Adrisbd11/Custom-Nanorobot-Control-Inverter/DATASHEETS/BMI Electronic Hardware PR-Photo.jpg

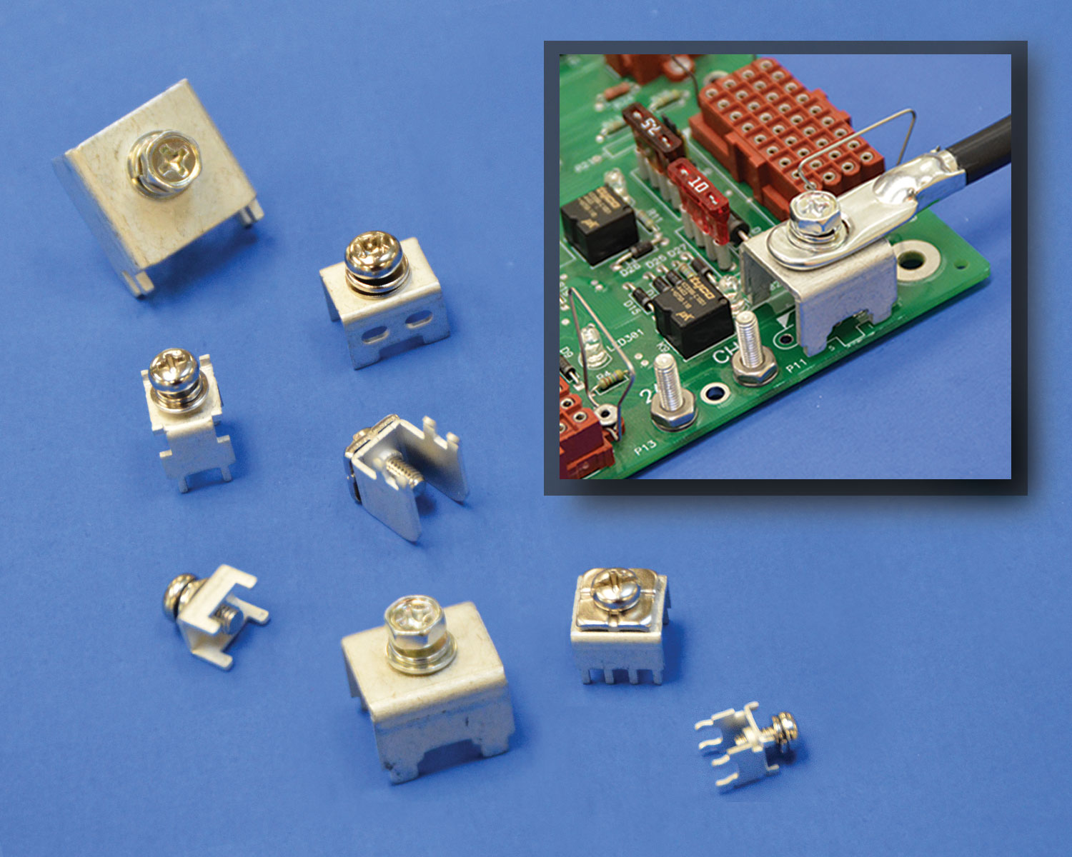
DATASHEETS/BMI Electronic Hardware PR-Photo.jpg
