Adrisbd11/Custom-Nanorobot-Control-Inverter/DATASHEETS/6130XX11821_61301811821/6130XX11821_61301811821.step

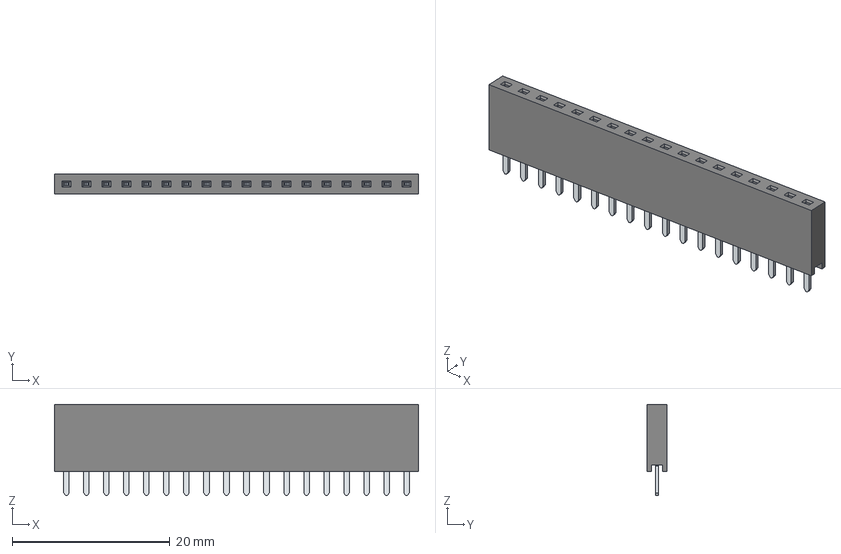
[picture p2: CAD file, 2026-04-30]
DATASHEETS/6130XX11821_61301811821/6130XX11821_61301811821.step
46.2 x 2.50 x 11.6 mm
