Adrisbd11/Custom-Nanorobot-Control-Inverter/DATASHEETS/C5750X7R2A475M230KA/C5750X7R2A475M230KA.step

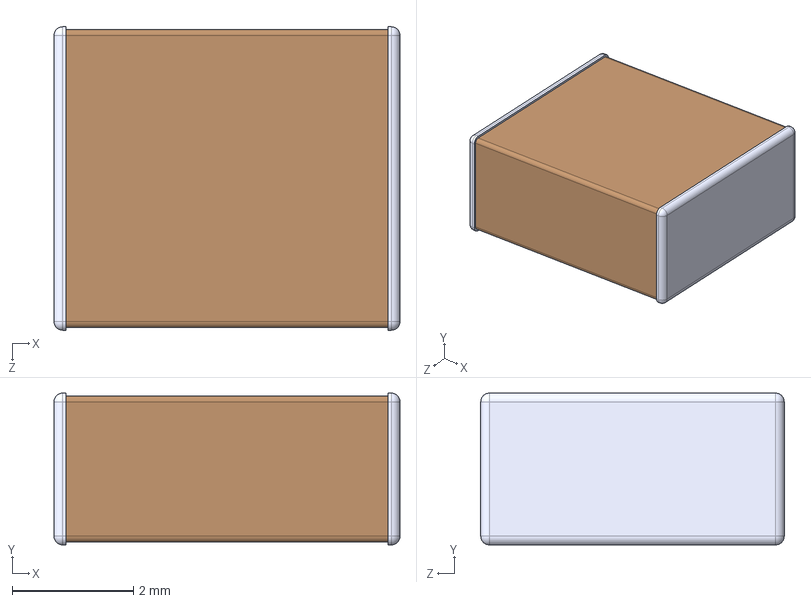
[picture p3: CAD file, 2026-04-30]
DATASHEETS/C5750X7R2A475M230KA/C5750X7R2A475M230KA.step
5.70 x 2.50 x 5.00 mm
