Adrisbd11/Custom-Nanorobot-Control-Inverter/DATASHEETS/LIB_2EDL23N06PJ/2EDL23N06PJ/3D/2EDL23N06PJ.stp

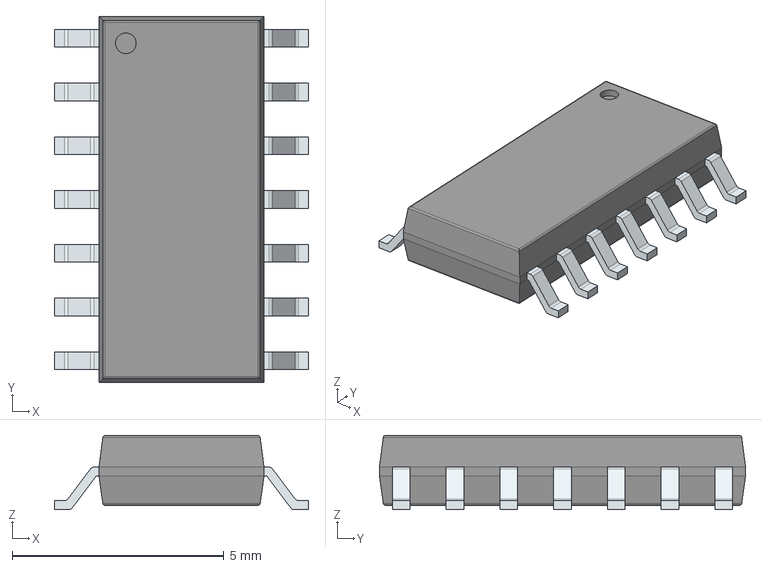
[picture p4: CAD file, 2026-04-17]
DATASHEETS/LIB_2EDL23N06PJ/2EDL23N06PJ/3D/2EDL23N06PJ.stp
6.00 x 8.65 x 1.75 mm
PinsArrayLR
