Adrisbd11/Custom-Nanorobot-Control-Inverter/DATASHEETS/LIB_C5750X6S2W225K250KA/C5750X6S2W225K250KA/3D/C5750X6S2W225K250KA.stp

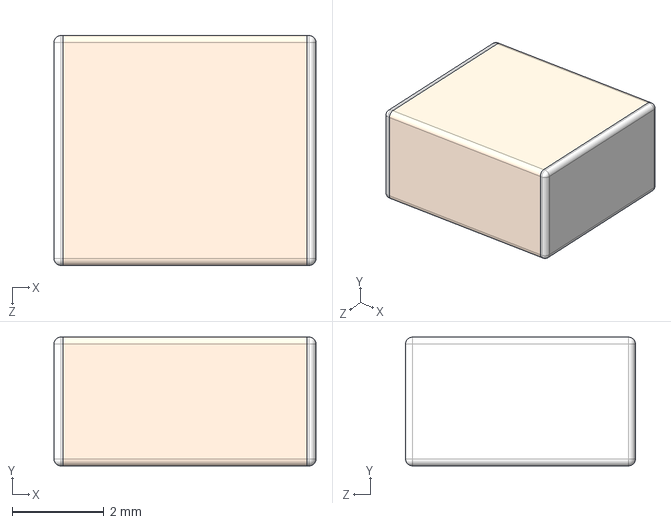
[picture p5: CAD file, 2026-04-30]
DATASHEETS/LIB_C5750X6S2W225K250KA/C5750X6S2W225K250KA/3D/C5750X6S2W225K250KA.stp
5.70 x 2.80 x 5.00 mm
