Adrisbd11/Custom-Nanorobot-Control-Inverter/DATASHEETS/LIB_CKSR_15-NP/CKSR_15-NP/3D/CKSR_15-NP.stp

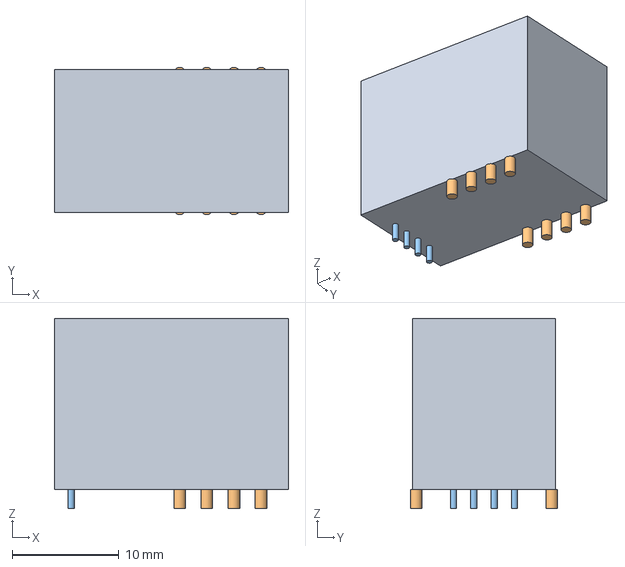
[picture p6: CAD file, 2026-04-17]
DATASHEETS/LIB_CKSR_15-NP/CKSR_15-NP/3D/CKSR_15-NP.stp
21.9 x 13.8 x 17.8 mm
Lugs x 12
