Adrisbd11/Custom-Nanorobot-Control-Inverter/DATASHEETS/LIB_CKSR_6-NP/CKSR_6-NP/3D/CKSR_6-NP.stp

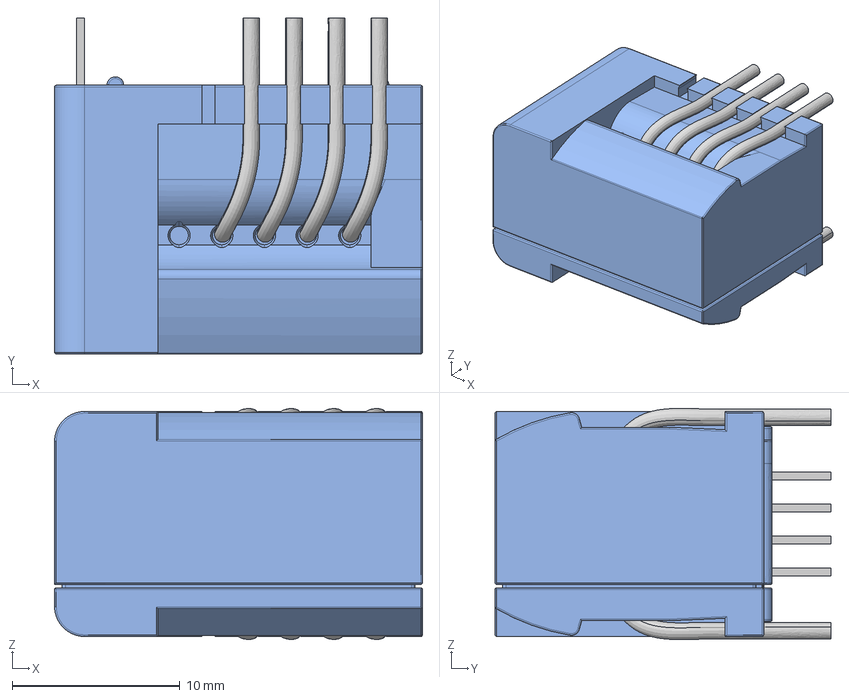
[picture p7: CAD file, 2026-04-30]
DATASHEETS/LIB_CKSR_6-NP/CKSR_6-NP/3D/CKSR_6-NP.stp
21.9 x 20.0 x 13.8 mm
1.Case
sec4.2 x 4
jumper.3 x 4
