Adrisbd11/Custom-Nanorobot-Control-Inverter/DATASHEETS/LIB_CRCW251215K0FKEG/CRCW251215K0FKEG/3D/CRCW251215K0FKEG.stp

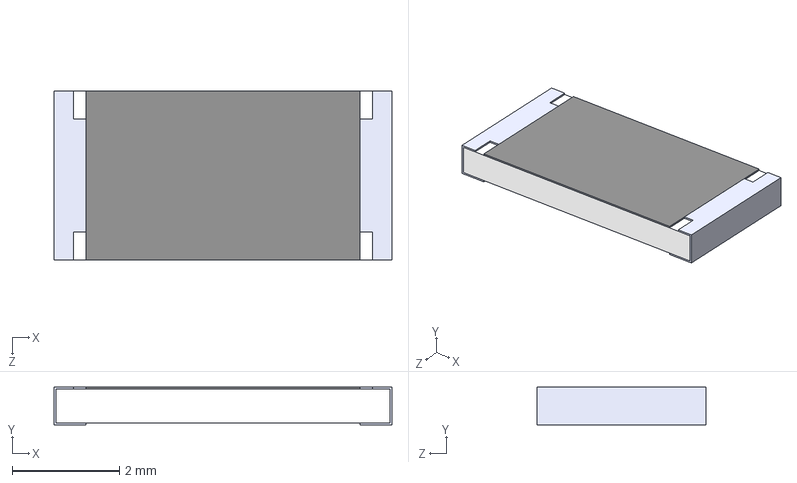
[picture p8: CAD file, 2026-04-17]
DATASHEETS/LIB_CRCW251215K0FKEG/CRCW251215K0FKEG/3D/CRCW251215K0FKEG.stp
6.30 x 0.7 x 3.15 mm
