Adrisbd11/Custom-Nanorobot-Control-Inverter/DATASHEETS/LIB_IPP111N15N3GXKSA1/IPP111N15N3GXKSA1/3D/IPP111N15N3GXKSA1.stp

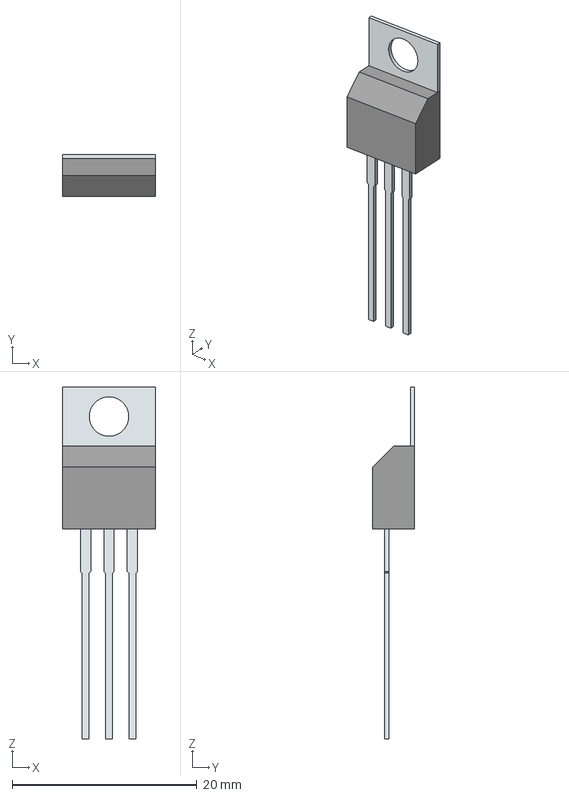
[picture p9: CAD file, 2026-04-30]
DATASHEETS/LIB_IPP111N15N3GXKSA1/IPP111N15N3GXKSA1/3D/IPP111N15N3GXKSA1.stp
10.0 x 4.57 x 38.1 mm
Tab
PinsArray
