Adrisbd11/Custom-Nanorobot-Control-Inverter/DATASHEETS/LIB_IPT034N15NM6ATMA1/IPT034N15NM6ATMA1/3D/IPT034N15NM6ATMA1.stp

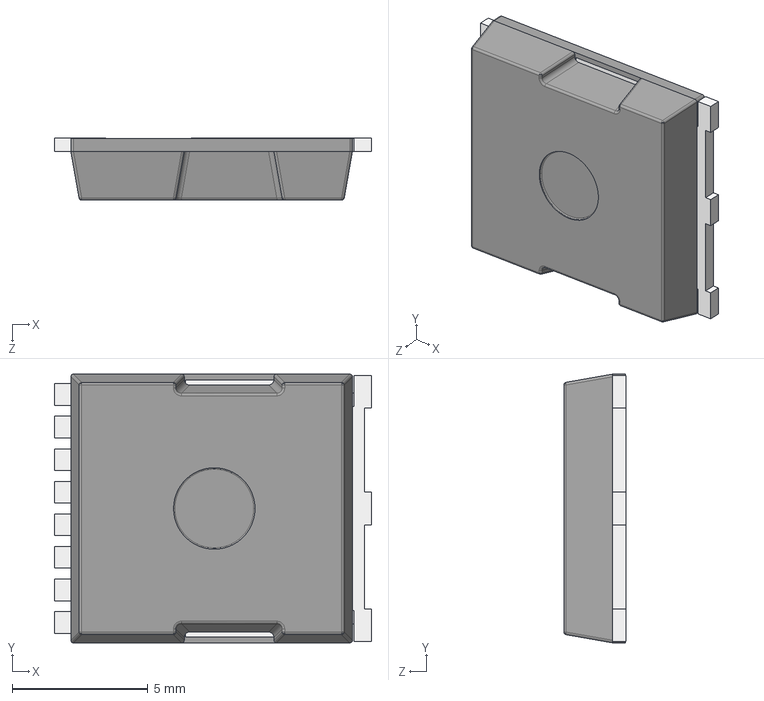
[picture p10: CAD file, 2026-04-17]
DATASHEETS/LIB_IPT034N15NM6ATMA1/IPT034N15NM6ATMA1/3D/IPT034N15NM6ATMA1.stp
11.7 x 9.90 x 2.30 mm
