Adrisbd11/Custom-Nanorobot-Control-Inverter/DATASHEETS/LIB_L6986H/L6986H/3D/L6986H.stp

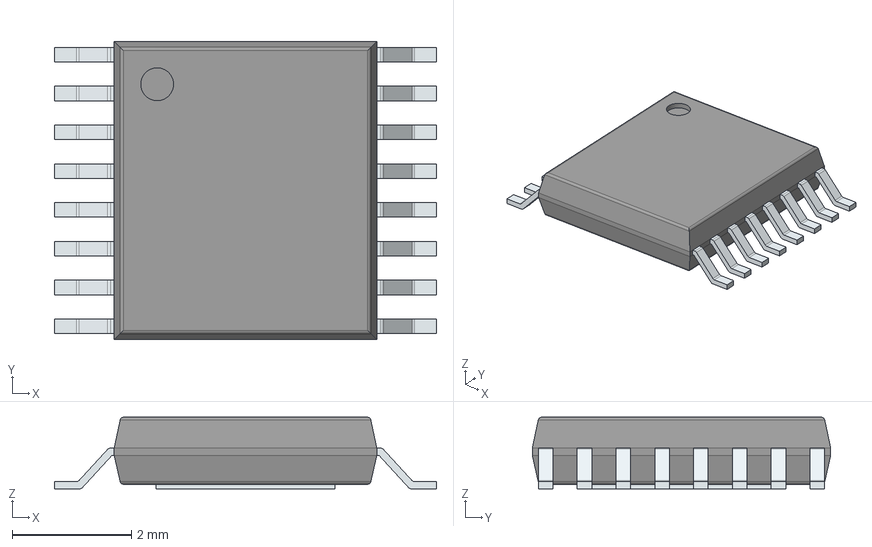
[picture p11: CAD file, 2026-04-17]
DATASHEETS/LIB_L6986H/L6986H/3D/L6986H.stp
6.40 x 5.00 x 1.20 mm
PinsArrayLR
ThermalPad
