Adrisbd11/Custom-Nanorobot-Control-Inverter/DATASHEETS/LIB_MKP1F044706J00JSSD/MKP1F044706J00JSSD/3D/MKP1F044706J00JSSD.stp

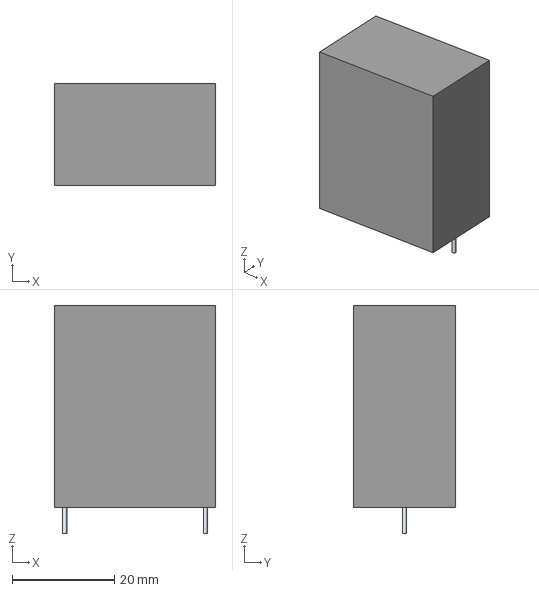
[picture p12: CAD file, 2026-04-17]
DATASHEETS/LIB_MKP1F044706J00JSSD/MKP1F044706J00JSSD/3D/MKP1F044706J00JSSD.stp
31.5 x 20.0 x 44.6 mm
Leads
