Adrisbd11/Custom-Nanorobot-Control-Inverter/DATASHEETS/LIB_MSS1P4-M3_89A/MSS1P4-M3_89A/3D/MSS1P4-M3_89A.stp

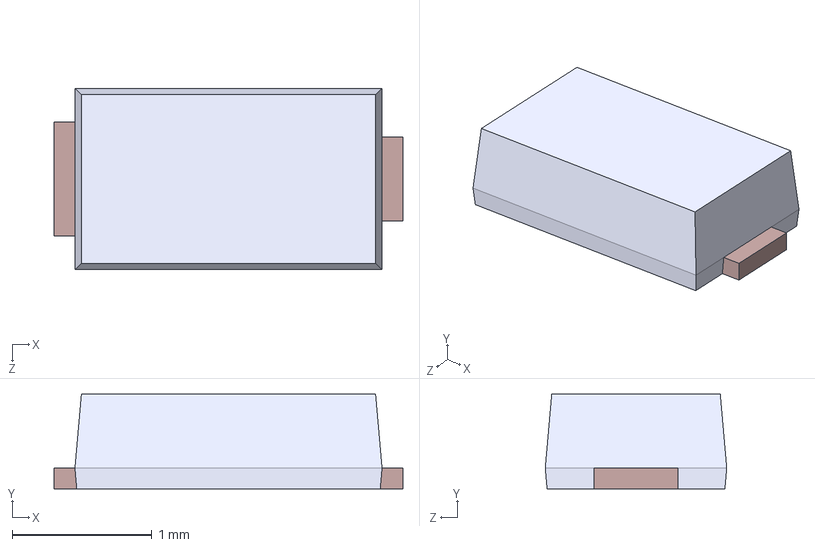
[picture p13: CAD file, 2026-04-17]
DATASHEETS/LIB_MSS1P4-M3_89A/MSS1P4-M3_89A/3D/MSS1P4-M3_89A.stp
2.50 x 0.68 x 1.30 mm
