Adrisbd11/Custom-Nanorobot-Control-Inverter/DATASHEETS/LIB_NCM3S1212MC-R7/NCM3S1212MC-R7/3D/NCM3S1212MC-R7.stp

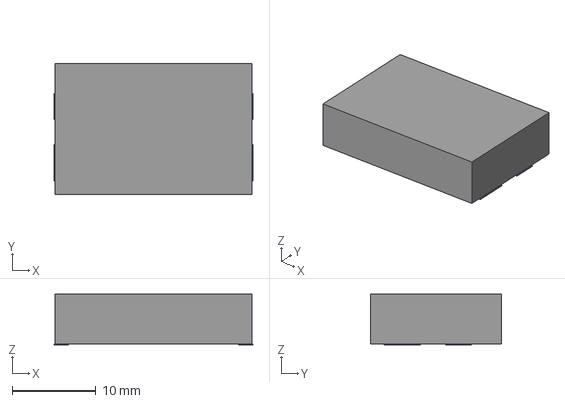
[picture p14: CAD file, 2026-04-17]
DATASHEETS/LIB_NCM3S1212MC-R7/NCM3S1212MC-R7/3D/NCM3S1212MC-R7.stp
23.8 x 15.6 x 6.05 mm
Pins
