Adrisbd11/Custom-Nanorobot-Control-Inverter/DATASHEETS/LIB_REF1933AIDDCR/REF1933AIDDCR/3D/REF1933AIDDCR.stp

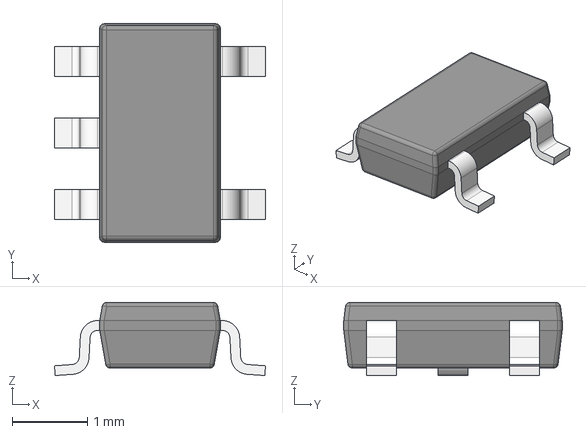
[picture p15: CAD file, 2026-04-17]
DATASHEETS/LIB_REF1933AIDDCR/REF1933AIDDCR/3D/REF1933AIDDCR.stp
2.80 x 2.90 x 0.97 mm
BODY-SOT
LEAD-SOT x 5
