Adrisbd11/Custom-Nanorobot-Control-Inverter/DATASHEETS/LIB_STPS20200CTN/STPS20200CTN/3D/STPS20200CTN.stp

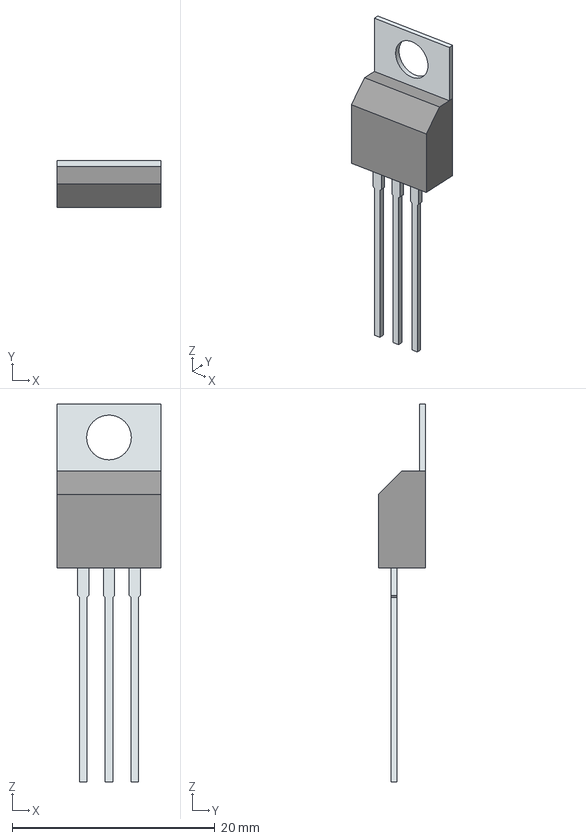
[picture p16: CAD file, 2026-04-17]
DATASHEETS/LIB_STPS20200CTN/STPS20200CTN/3D/STPS20200CTN.stp
10.2 x 4.60 x 37.2 mm
Tab
PinsArray
