Adrisbd11/Custom-Nanorobot-Control-Inverter/DATASHEETS/LIB_TPS7A2030PDBVR/TPS7A2030PDBVR/3D/TPS7A2030PDBVR.stp

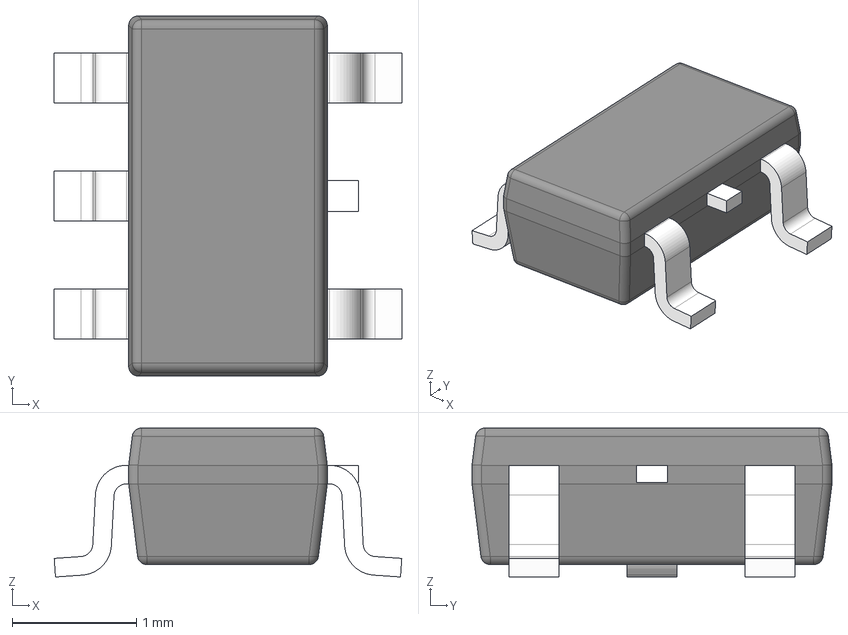
[picture p17: CAD file, 2026-04-17]
DATASHEETS/LIB_TPS7A2030PDBVR/TPS7A2030PDBVR/3D/TPS7A2030PDBVR.stp
2.80 x 2.90 x 1.20 mm
BODY-SOT
LEAD-SOT x 5
LEAD-DUMMY
