Adrisbd11/Custom-Nanorobot-Control-Inverter/DATASHEETS/MSS1P4-M3_89A/MSS1P4-M3_89A.step

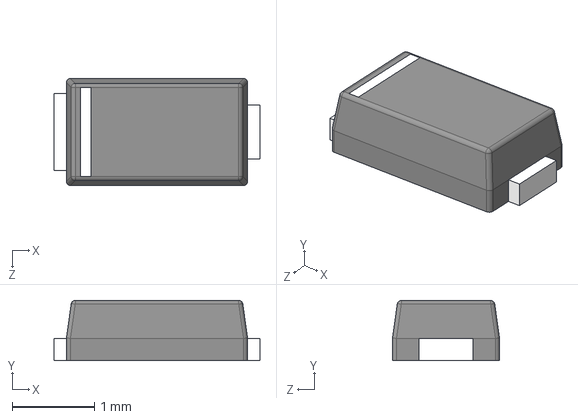
[picture p18: CAD file, 2026-04-30]
DATASHEETS/MSS1P4-M3_89A/MSS1P4-M3_89A.step
2.50 x 0.73 x 1.30 mm
