Adrisbd11/Custom-Nanorobot-Control-Inverter/DATASHEETS/NUCLEO-G431KB/ojovienedeotraweb/NUCLEO-G431KB.stp

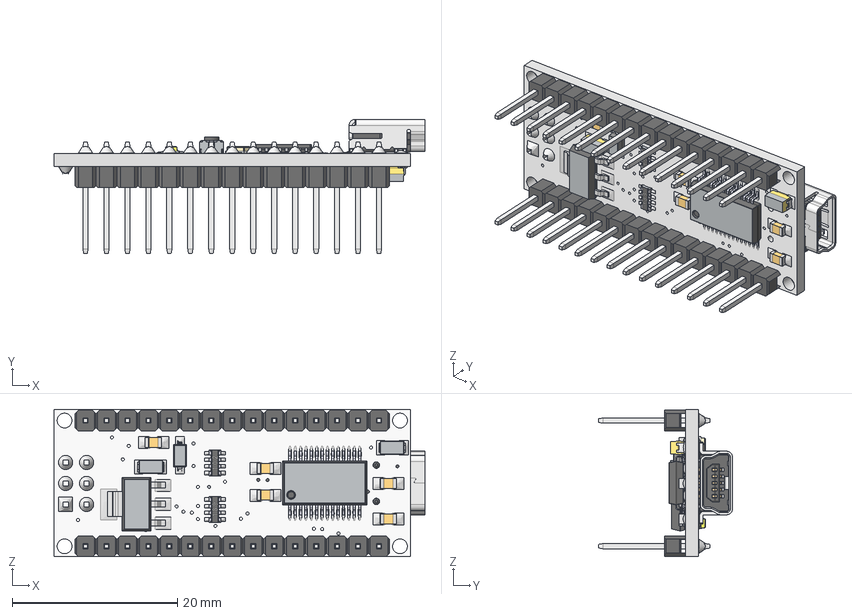
[picture p19: CAD file, 2026-04-30]
DATASHEETS/NUCLEO-G431KB/ojovienedeotraweb/NUCLEO-G431KB.stp
45.0 x 16.2 x 17.8 mm
nano board
atmega328
PLD-2.step x 3
1x15 Male Pin Header x 2
FTDI FT232RL
User Library-C0805-2.step x 5
0805 Chip SMD LED (2x1.2mm).step x 4
SMD Crystal 16MHz
Mini B USB
Tantalum Capacitor 475C A3216 x 2
Pushbutton3x4x2
C5 FD10 Reg
Diode MBR0520
102 RESISTOR PACK
189 RESISTOR PACK
