Adrisbd11/Custom-Nanorobot-Control-Inverter/DATASHEETS/SN74LVC1G04DCKTG4/SN74LVC1G04DCKTG4.step

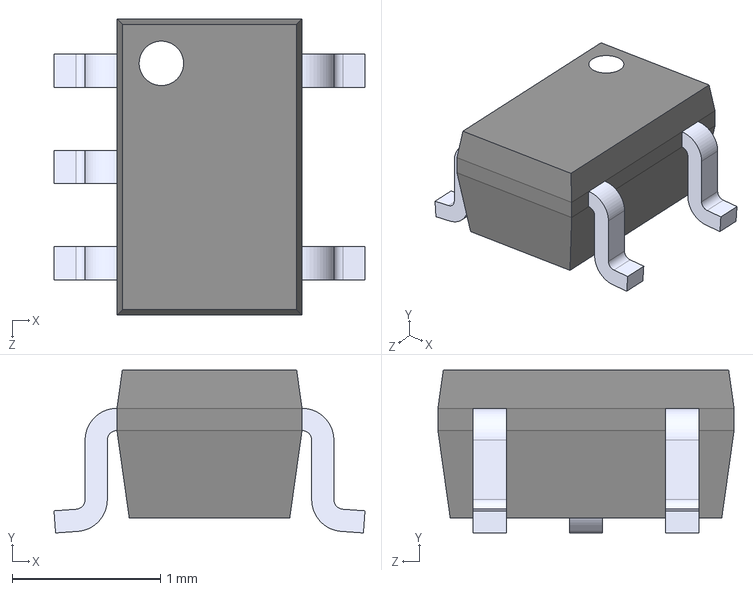
[picture p20: CAD file, 2026-04-17]
DATASHEETS/SN74LVC1G04DCKTG4/SN74LVC1G04DCKTG4.step
2.10 x 1.10 x 2.00 mm
