Adrisbd11/Custom-Nanorobot-Control-Inverter/DATASHEETS/STM32G474RET6/STM32G474RET6.step

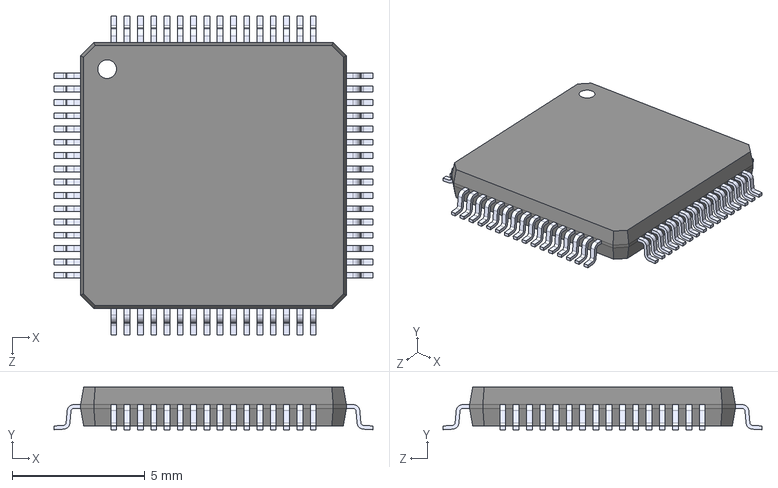
[picture p21: CAD file, 2026-04-17]
DATASHEETS/STM32G474RET6/STM32G474RET6.step
12.0 x 1.60 x 12.0 mm
