Adrisbd11/Custom-Nanorobot-Control-Inverter/DATASHEETS/TLV3201AIDBVT/TLV3201AIDBVT.step

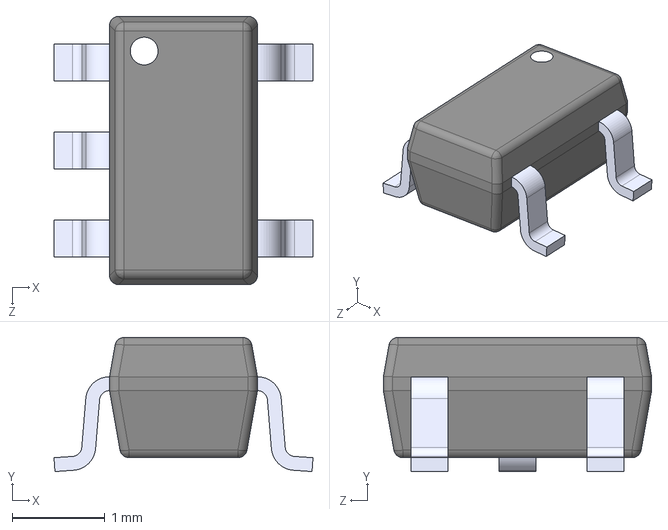
[picture p22: CAD file, 2026-04-17]
DATASHEETS/TLV3201AIDBVT/TLV3201AIDBVT.step
2.80 x 1.45 x 2.90 mm
