Adrisbd11/Custom-Nanorobot-Control-Inverter/(list of files, cad)

Other CAD files:
DATASHEETS/LIB_CKSR_25-NP/CKSR_25-NP/3D/CKSR_25-NP.stp
DATASHEETS/LIB_1705469/1705469/3D/1705469.stp
DATASHEETS/LIB_1705469/1705469/Allegro/1705469.psm
DATASHEETS/LIB_1705469/1705469/DEHDL/1705469/chips/chips.prt
DATASHEETS/LIB_1729128/1729128/3D/1729128.stp
DATASHEETS/LIB_1729128/1729128/Allegro/1729128.psm
DATASHEETS/LIB_1729128/1729128/DEHDL/1729128/chips/chips.prt
DATASHEETS/LIB_2EDL23N06PJ/2EDL23N06PJ/Allegro/soic127p600x175-14n.psm
DATASHEETS/LIB_2EDL23N06PJ/2EDL23N06PJ/DEHDL/2edl23n06pj/chips/chips.prt
DATASHEETS/LIB_B43547F2108M067/B43547F2108M067/3D/B43547F2108M067.stp
DATASHEETS/LIB_B43547F2108M067/B43547F2108M067/Allegro/capprd1000w190d3550h4200.psm
DATASHEETS/LIB_B43547F2108M067/B43547F2108M067/DEHDL/b43547f2108m067/chips/chips.prt
DATASHEETS/LIB_C5750X6S2W225K250KA/C5750X6S2W225K250KA/Allegro/c5750_commercial.psm
DATASHEETS/LIB_C5750X6S2W225K250KA/C5750X6S2W225K250KA/DEHDL/c5750x6s2w225k250ka/chips/chips.prt
DATASHEETS/LIB_CKSR_15-NP/CKSR_15-NP/Allegro/cksr15np.psm
DATASHEETS/LIB_CKSR_15-NP/CKSR_15-NP/DEHDL/cksr_15_np/chips/chips.prt
DATASHEETS/LIB_CKSR_25-NP/CKSR_25-NP/Allegro/cksr25np.psm
DATASHEETS/LIB_CKSR_25-NP/CKSR_25-NP/DEHDL/cksr_25_np/chips/chips.prt
DATASHEETS/LIB_CKSR_6-NP/CKSR_6-NP/Allegro/cksr6np.psm
DATASHEETS/LIB_CKSR_6-NP/CKSR_6-NP/DEHDL/cksr_6_np/chips/chips.prt
DATASHEETS/LIB_CRCW251215K0FKEG/CRCW251215K0FKEG/Allegro/resc6332x70n.psm
DATASHEETS/LIB_CRCW251215K0FKEG/CRCW251215K0FKEG/DEHDL/crcw251215k0fkeg/chips/chips.prt
DATASHEETS/LIB_D22V0H1U2LP-7B/D22V0H1U2LP-7B/Allegro/d22v0h1u2lp7b.psm
DATASHEETS/LIB_D22V0H1U2LP-7B/D22V0H1U2LP-7B/DEHDL/d22v0h1u2lp_7b/chips/chips.prt
DATASHEETS/LIB_IPP111N15N3GXKSA1/IPP111N15N3GXKSA1/Allegro/to254p457x1003x2115-3p.psm
DATASHEETS/LIB_IPP111N15N3GXKSA1/IPP111N15N3GXKSA1/DEHDL/ipp111n15n3gxksa1/chips/chips.prt
DATASHEETS/LIB_IPT034N15NM6ATMA1/IPT034N15NM6ATMA1/DEHDL/ipt034n15nm6atma1/chips/chips.prt
DATASHEETS/LIB_L6986H/L6986H/Allegro/sop65p640x120-17n.psm
DATASHEETS/LIB_L6986H/L6986H/DEHDL/l6986h/chips/chips.prt
DATASHEETS/LIB_MKP1F044706J00JSSD/MKP1F044706J00JSSD/Allegro/mkp1f044706j00jssd.psm
DATASHEETS/LIB_MKP1F044706J00JSSD/MKP1F044706J00JSSD/DEHDL/mkp1f044706j00jssd/chips/chips.prt
DATASHEETS/LIB_MSS1P4-M3_89A/MSS1P4-M3_89A/Allegro/microsmp.psm
DATASHEETS/LIB_MSS1P4-M3_89A/MSS1P4-M3_89A/DEHDL/mss1p4_m3_89a/chips/chips.prt
DATASHEETS/LIB_NCM3S1212MC-R7/NCM3S1212MC-R7/Allegro/ncm3s1212mcr7.psm
DATASHEETS/LIB_NCM3S1212MC-R7/NCM3S1212MC-R7/DEHDL/ncm3s1212mc_r7/chips/chips.prt
DATASHEETS/LIB_REF1933AIDDCR/REF1933AIDDCR/Allegro/sot95p280x110-5n.psm
DATASHEETS/LIB_REF1933AIDDCR/REF1933AIDDCR/DEHDL/ref1933aiddcr/chips/chips.prt
DATASHEETS/LIB_SS3P4-M3_85A/SS3P4-M3_85A/Allegro/ss3p4m385a.psm
DATASHEETS/LIB_SS3P4-M3_85A/SS3P4-M3_85A/DEHDL/ss3p4_m3_85a/chips/chips.prt
DATASHEETS/LIB_STPS20200CTN/STPS20200CTN/Allegro/to255p460x1020x1905-3p.psm
DATASHEETS/LIB_STPS20200CTN/STPS20200CTN/DEHDL/stps20200ctn/chips/chips.prt
DATASHEETS/LIB_TLF80511TFV50ATMA1/TLF80511TFV50ATMA1/3D/TLF80511TFV50ATMA1.stp
DATASHEETS/LIB_TLF80511TFV50ATMA1/TLF80511TFV50ATMA1/Allegro/idd09e60.psm
DATASHEETS/LIB_TLF80511TFV50ATMA1/TLF80511TFV50ATMA1/DEHDL/tlf80511tfv50atma1/chips/chips.prt
DATASHEETS/LIB_TPS7A2030PDBVR/TPS7A2030PDBVR/Allegro/sot95p280x145-5n.psm
DATASHEETS/LIB_TPS7A2030PDBVR/TPS7A2030PDBVR/DEHDL/tps7a2030pdbvr/chips/chips.prt
DATASHEETS/LIB_UCC21521DW/UCC21521DW/3D/UCC21521DW.stp
DATASHEETS/LIB_UCC21521DW/UCC21521DW/Allegro/soic127p1030x265-16n.psm
DATASHEETS/LIB_UCC21521DW/UCC21521DW/DEHDL/ucc21521dw/chips/chips.prt
DATASHEETS/M20-7821546/ojodesnapmagic/m20-7821546.stp
DATASHEETS/TLF80511TF_V50/TLF80511TFV50ATMA1.stp
DATASHEETS/UCC21521DW/UCC21521DW.step
