Adrisbd11/Custom-Nanorobot-Control-Inverter/(list of files, drawings)

Other design files:
DATASHEETS/LIB_2EDL23N06PJ/2EDL23N06PJ/Altium/2EDL23N06PJ.SchLib
DATASHEETS/LIB_2EDL23N06PJ/2EDL23N06PJ/Altium/SOIC127P600X175-14N.PcbLib
DATASHEETS/LIB_1705469/1705469/Altium/1705469.PcbLib
DATASHEETS/LIB_1705469/1705469/Altium/1705469.SchLib
DATASHEETS/LIB_B43547F2108M067/B43547F2108M067/Altium/B43547F2108M067.SchLib
DATASHEETS/LIB_B43547F2108M067/B43547F2108M067/Altium/CAPPRD1000W190D3550H4200.PcbLib
DATASHEETS/LIB_CKSR_15-NP/CKSR_15-NP/Altium/CKSR15NP.PcbLib
DATASHEETS/LIB_CKSR_15-NP/CKSR_15-NP/Altium/CKSR_15-NP.SchLib
DATASHEETS/LIB_CKSR_25-NP/CKSR_25-NP/Altium/CKSR25NP.PcbLib
DATASHEETS/LIB_CKSR_25-NP/CKSR_25-NP/Altium/CKSR_25-NP.SchLib
DATASHEETS/LIB_CRCW251215K0FKEG/CRCW251215K0FKEG/Altium/CRCW251215K0FKEG.SchLib
DATASHEETS/LIB_CRCW251215K0FKEG/CRCW251215K0FKEG/Altium/RESC6332X70N.PcbLib
DATASHEETS/LIB_IPP111N15N3GXKSA1/IPP111N15N3GXKSA1/Altium/IPP111N15N3GXKSA1.SchLib
DATASHEETS/LIB_IPP111N15N3GXKSA1/IPP111N15N3GXKSA1/Altium/TO254P457X1003X2115-3P.PcbLib
DATASHEETS/LIB_L6986H/L6986H/Altium/L6986H.SchLib
DATASHEETS/LIB_L6986H/L6986H/Altium/SOP65P640X120-17N.PcbLib
DATASHEETS/LIB_MKP1F044706J00JSSD/MKP1F044706J00JSSD/Altium/MKP1F044706J00JSSD.PcbLib
DATASHEETS/LIB_MKP1F044706J00JSSD/MKP1F044706J00JSSD/Altium/MKP1F044706J00JSSD.SchLib
DATASHEETS/LIB_NCM3S1212MC-R7/NCM3S1212MC-R7/Altium/NCM3S1212MC-R7.SchLib
DATASHEETS/LIB_NCM3S1212MC-R7/NCM3S1212MC-R7/Altium/NCM3S1212MCR7.PcbLib
DATASHEETS/LIB_REF1933AIDDCR/REF1933AIDDCR/Altium/REF1933AIDDCR.SchLib
DATASHEETS/LIB_REF1933AIDDCR/REF1933AIDDCR/Altium/SOT95P280X110-5N.PcbLib
DATASHEETS/LIB_SS3P4-M3_85A/SS3P4-M3_85A/Altium/SS3P4-M3_85A.SchLib
DATASHEETS/LIB_SS3P4-M3_85A/SS3P4-M3_85A/Altium/SS3P4M385A.PcbLib
DATASHEETS/LIB_STPS20200CTN/STPS20200CTN/Altium/STPS20200CTN.SchLib
DATASHEETS/LIB_STPS20200CTN/STPS20200CTN/Altium/TO255P460X1020X1905-3P.PcbLib
DATASHEETS/LIB_TPS7A2030PDBVR/TPS7A2030PDBVR/Altium/SOT95P280X145-5N.PcbLib
DATASHEETS/LIB_TPS7A2030PDBVR/TPS7A2030PDBVR/Altium/TPS7A2030PDBVR.SchLib
DATASHEETS/LIB_UCC21521DW/UCC21521DW/Altium/SOIC127P1030X265-16N.PcbLib
DATASHEETS/LIB_UCC21521DW/UCC21521DW/Altium/UCC21521DW.SchLib
