Adrisbd11/Custom-Nanorobot-Control-Inverter/Adrion_1/Adrion_1.kicad_pcb

## KiCad design Adrion_1/Adrion_1.kicad_pcb (2026-05-08)

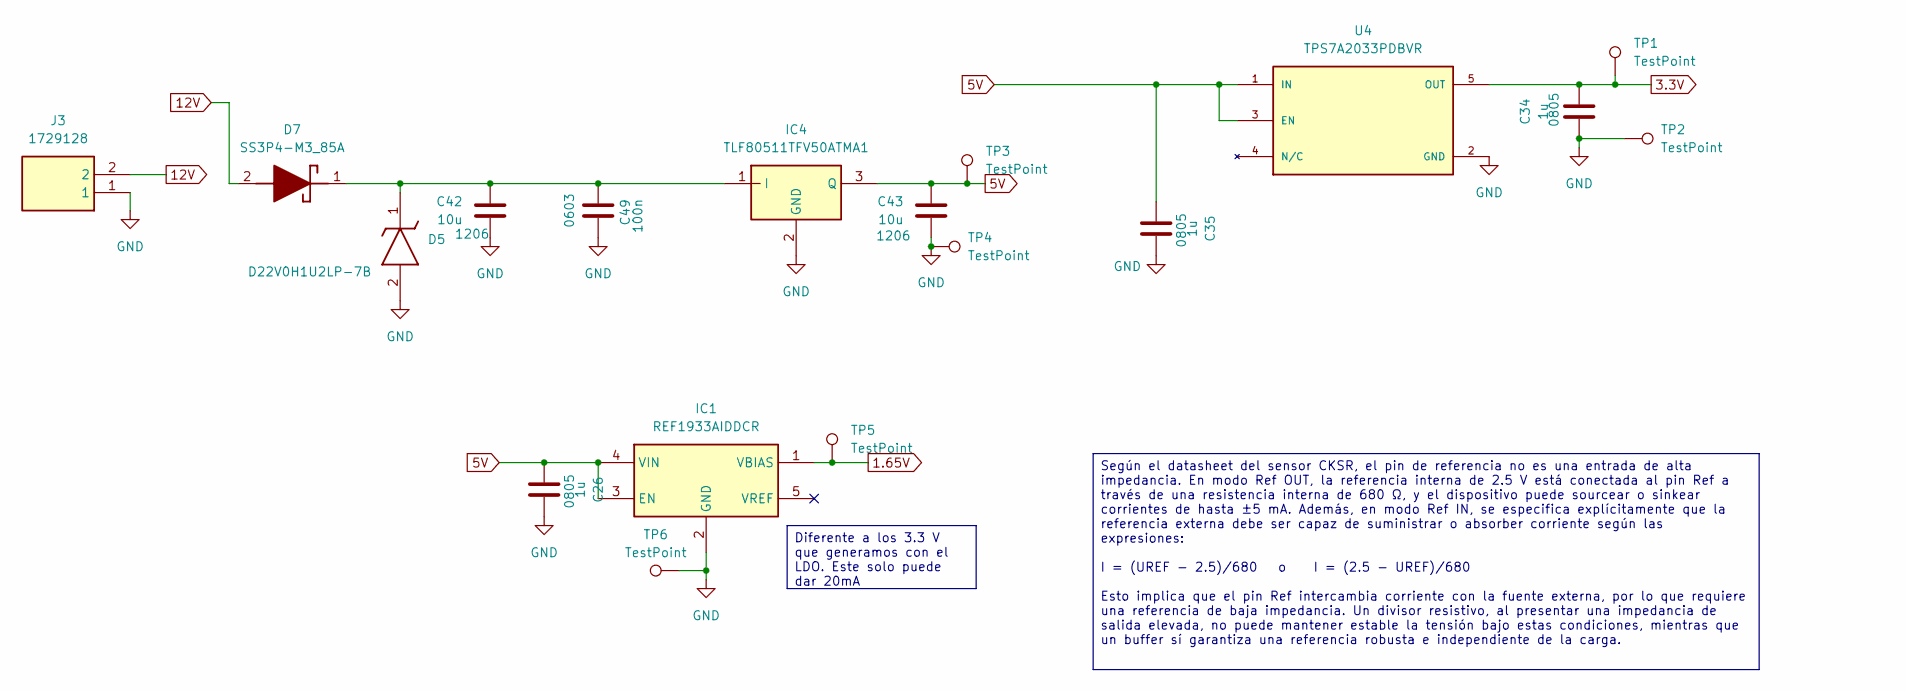
[picture p23: schematic supply.kicad_sch]

Parts:
C26, C34, C35: 1u; C_0805_2012Metric
C42, C43: 10u; C_1206_3216Metric
C49: 100n; C_0603_1608Metric
D5: D22V0H1U2LP-7B; D22V0H1U2LP7B; Manufacturer_Part_Number D22V0H1U2LP-7B
D7: SS3P4-M3_85A; SS3P4M385A; Manufacturer_Part_Number SS3P4-M3/85A; Mouser Part Number 625-SS3P4-M3/85A
IC1: REF1933AIDDCR; SOT95P280X110-5N; Manufacturer_Part_Number REF1933AIDDCR; Mouser Part Number 595-REF1933AIDDCR
IC4: TLF80511TFV50ATMA1; IDD09E60; Manufacturer_Part_Number TLF80511TFV50ATMA1; Mouser Part Number 726-TLF80511TFV50ATM
J3: 1729128; Manufacturer_Part_Number 1729128; Mouser Part Number 651-1729128
TP1, TP2, TP3, TP4, TP5, TP6: TestPoint; TestPoint_Pad_D1.0mm
U4: TPS7A2033PDBVR; SOT95P280X145-5N; PARTREV H

Connections:
1.65V: IC1.1 (VBIAS), TP5.1; also elsewhere on the board
3.3V: C34.2, TP1.1, U4.5 (OUT); also elsewhere on the board
5V: C26.1, C35.1, C43.1, IC1.3 (EN), IC1.4 (VIN), IC4.3 (Q), TP3.1, U4.1 (IN), U4.3 (EN); also elsewhere on the board
12V: D7.2 (A), J3.2; also elsewhere on the board
GND: C26.2, C34.1, C35.2, C42.2, C43.2, C49.1, D5.2 (A), IC1.2 (GND), IC4.2 (GND), J3.1, TP2.1, TP4.1, TP6.1, U4.2 (GND); also elsewhere on the board
unnamed: C42.1, C49.2, D5.1 (K), D7.1 (K), IC4.1 (I)

Notes on the sheet:
Diferente a los 3.3 V que generamos con el LDO. Este solo puede dar 20mA
Según el datasheet del sensor CKSR, el pin de referencia no es una entrada de alta impedancia. En modo Ref OUT, la referencia interna de 2.5 V está conectada al pin Ref a través de una resistencia interna de 680 Ω, y el dispositivo puede sourcear o sinkear corrientes de hasta ±5 mA. Además, en modo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

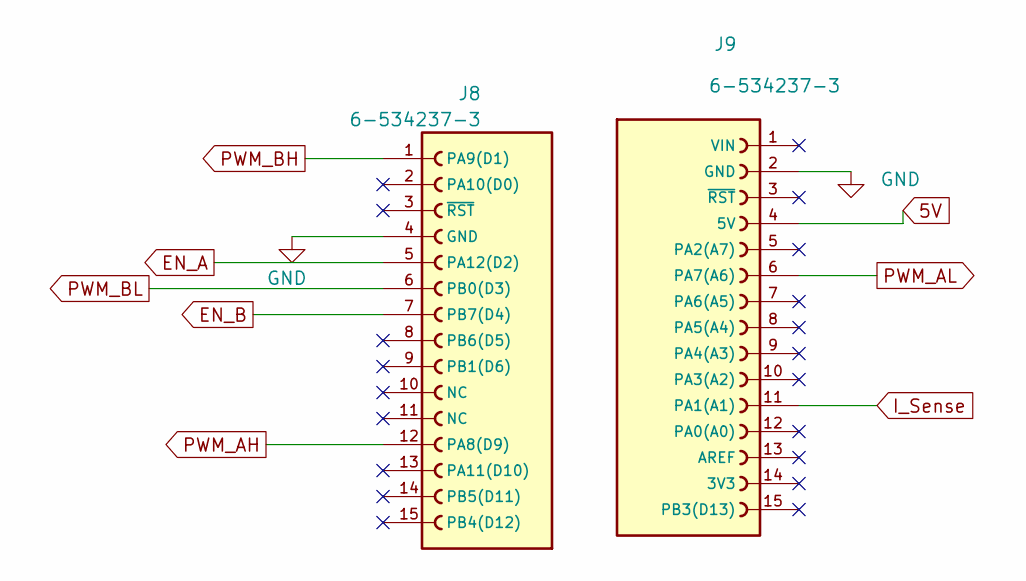
[picture p24: schematic untitled.kicad_sch]

Parts:
J8, J9: 6-534237-3; TE_6-534237-3; PARTREV R

Connections:
5V: J9.4 (5V); also elsewhere on the board
EN_A: J8.5 (PA12(D2)); also elsewhere on the board
EN_B: J8.7 (PB7(D4)); also elsewhere on the board
GND: J8.4 (GND), J9.2 (GND); also elsewhere on the board
I_Sense: J9.11 (PA1(A1)); also elsewhere on the board
PWM_AH: J8.12 (PA8(D9)); also elsewhere on the board
PWM_AL: J9.6 (PA7(A6)); also elsewhere on the board
PWM_BH: J8.1 (PA9(D1)); also elsewhere on the board
PWM_BL: J8.6 (PB0(D3)); also elsewhere on the board

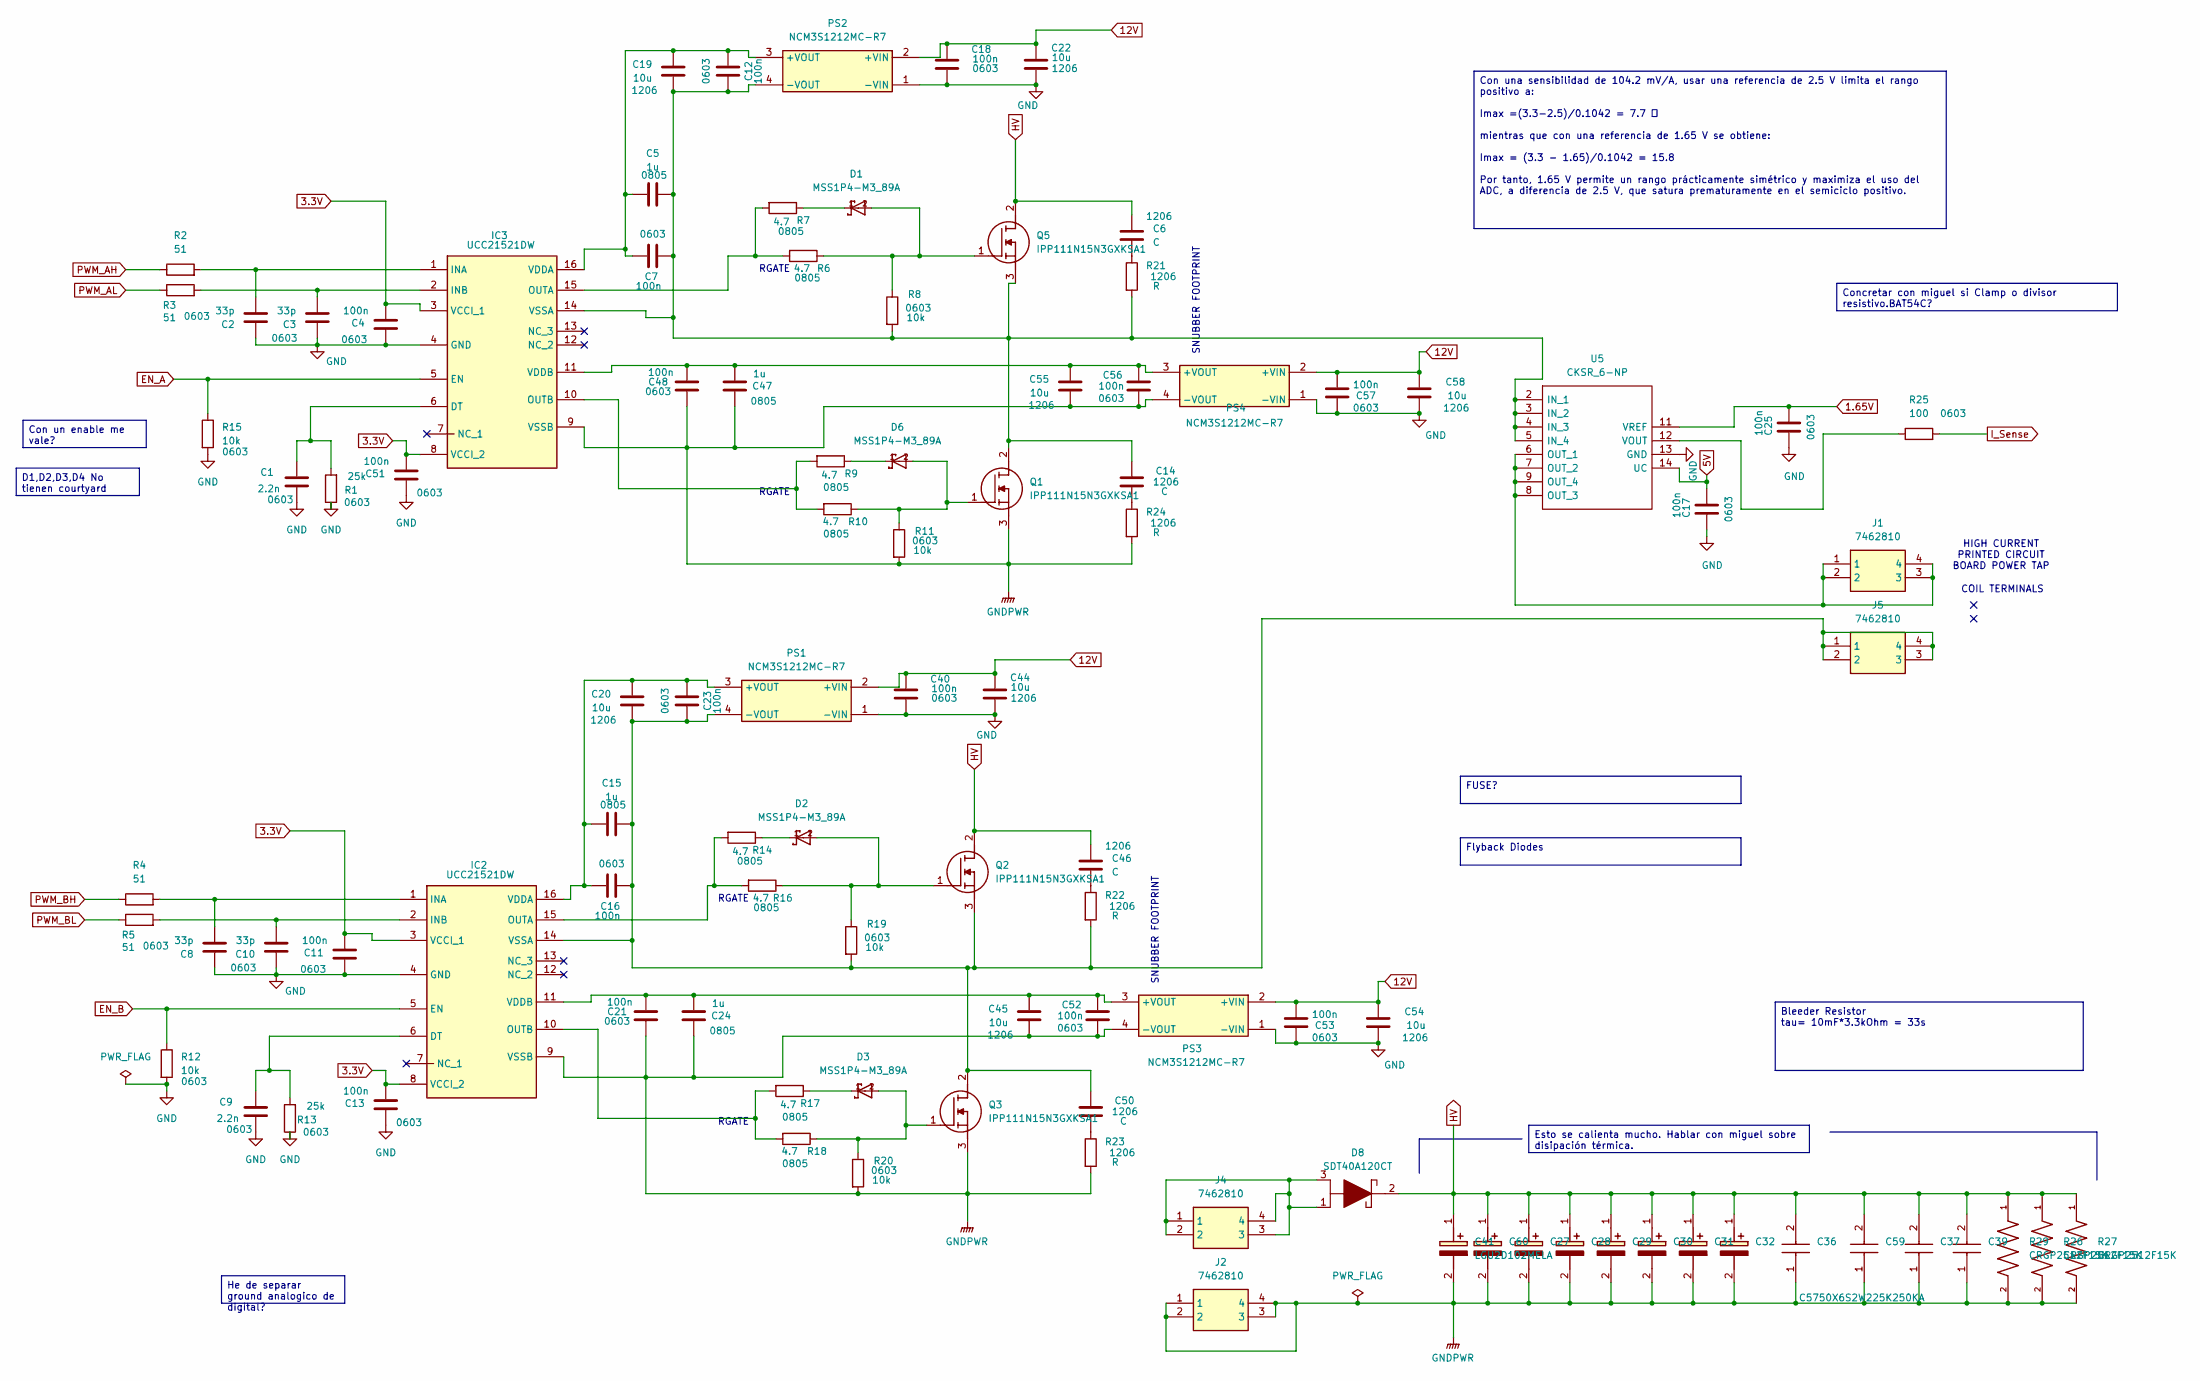
[picture p25: schematic Power_Stage.kicad_sch]

Parts:
C1, C9: 2.2n; C_0603_1608Metric_Pad1.08x0.95mm_HandSolder
C2, C3, C8, C10: 33p; C_0603_1608Metric_Pad1.08x0.95mm_HandSolder
C4, C11, C13, C51: 100n; C_0603_1608Metric_Pad1.08x0.95mm_HandSolder
C5, C15, C24, C47: 1u; C_0805_2012Metric
C6, C14, C46, C50: C; C_1206_3216Metric_Pad1.33x1.80mm_HandSolder
C7, C12, C16, C17, C18, C21, C23, C25, C40, C48, C52, C53, C56, C57: 100n; C_0603_1608Metric
C19, C20, C22, C44, C45, C54, C55, C58: 10u; C_1206_3216Metric
C27, C28, C29, C30, C31, C32, C41, C60: LGU2D102MELA; Manufacturer_Part_Number LGU2D102MELA; Mouser Part Number 647-LGU2D102MELA
C36, C37, C39, C59: C5750X6S2W225K250KA; C5750_Commercial; Manufacturer_Part_Number C5750X6S2W225K250KA; Mouser Part Number 810-C5750X6S2W225KKA
D1, D2, D3, D6: MSS1P4-M3_89A; DIODE_MSS1P4-M3_89A
D8: SDT40A120CT; TO254P1066X482X2286-3; Manufacturer_Part_Number STPS20200CTN
IC2, IC3: UCC21521DW; SOIC127P1030X265-16N; Manufacturer_Part_Number UCC21521DW; Mouser Part Number 595-UCC21521DW
J1, J2, J4, J5: 7462810; Manufacturer_Part_Number 7462810; Mouser Part Number 710-7462810
PS1, PS2, PS3, PS4: NCM3S1212MC-R7; NCM3S1212MCR7; Manufacturer_Part_Number NCM3S1212MC-R7
Q1, Q2, Q3, Q5: IPP111N15N3GXKSA1; TO254P457X1003X2115-3P; Manufacturer_Part_Number IPP111N15N3GXKSA1; Mouser Part Number 726-IPP111N15N3GXKSA
R1, R13: 25k; R_0603_1608Metric_Pad0.98x0.95mm_HandSolder
R2, R3, R4, R5: 51; R_0603_1608Metric_Pad0.98x0.95mm_HandSolder
R6, R7, R9, R10, R14, R16, R17, R18: 4.7; R_0805_2012Metric_Pad1.20x1.40mm_HandSolder
R8, R11, R12, R15, R19, R20: 10k; R_0603_1608Metric_Pad0.98x0.95mm_HandSolder
R21, R22, R23, R24: R; R_1206_3216Metric_Pad1.30x1.75mm_HandSolder
R25: 100; R_0603_1608Metric_Pad0.98x0.95mm_HandSolder
R26, R27, R29: CRGP2512F15K; RESC6332X65N
U5: CKSR_6-NP; CKSR6NP; Manufacturer_Part_Number CKSR 6-NP; Mouser Part Number 61-CKSR6-NP

Connections:
1.65V: C25.1, U5.11 (VREF); also elsewhere on the board
3.3V: C4.2, C11.2, C13.2, C51.2, IC2.3 (VCCI_1), IC2.8 (VCCI_2), IC3.3 (VCCI_1), IC3.8 (VCCI_2); also elsewhere on the board
5V: C17.1, U5.14 (UC); also elsewhere on the board
12V: C18.1, C22.1, C40.1, C44.1, C53.1, C54.1, C57.1, C58.1, PS1.2 (+VIN), PS2.2 (+VIN), PS3.2 (+VIN), PS4.2 (+VIN); also elsewhere on the board
EN_A: IC3.5 (EN), R15.1; also elsewhere on the board
EN_B: IC2.5 (EN), R12.1; also elsewhere on the board
GND: C1.2, C2.1, C3.1, C4.1, C8.1, C9.2, C10.1, C11.1, C13.1, C17.2, C18.2, C22.2, C25.2, C40.2, C44.2, C51.1, C53.2, C54.2, C57.2, C58.2, IC2.4 (GND), IC3.4 (GND), PS1.1 (-VIN), PS2.1 (-VIN), PS3.1 (-VIN), PS4.1 (-VIN), R1.1, R12.2, R13.1, R15.2, U5.13 (GND); also elsewhere on the board
GNDPWR: C21.2, C24.2, C27.2 (-), C28.2 (-), C29.2 (-), C30.2 (-), C31.2 (-), C32.2 (-), C36.1, C37.1, C39.1, C41.2 (-), C45.2, C47.2, C48.2, C52.2, C55.2, C56.2, C59.1, C60.2 (-), IC2.9 (VSSB), IC3.9 (VSSB), J2.1, J2.2, J2.3, J2.4, PS3.4 (-VOUT), PS4.4 (-VOUT), Q1.3 (S), Q3.3 (S), R11.2, R20.2, R23.2, R24.2, R26.2, R27.2, R29.2
HV: C6.1, C27.1 (+), C28.1 (+), C29.1 (+), C30.1 (+), C31.1 (+), C32.1 (+), C36.2, C37.2, C39.2, C41.1 (+), C46.1, C59.2, C60.1 (+), D8.2, Q2.2 (D), Q5.2 (D), R26.1, R27.1, R29.1
I_Sense: R25.2; also elsewhere on the board
unnamed: C6.2, R21.1
unnamed: C14.2, R24.1
unnamed: C46.2, R22.1
unnamed: C50.2, R23.1
unnamed: D1.1, R7.1
unnamed: D2.1, R14.1
unnamed: D3.1, R17.1
unnamed: D6.1, R9.1
unnamed: D8.1, D8.3, J4.1, J4.2, J4.3, J4.4
unnamed: C9.1, IC2.6 (DT), R13.2
unnamed: C8.2, IC2.1 (INA), R4.2
unnamed: C10.2, IC2.2 (INB), R5.2
unnamed: IC2.15 (OUTA), R14.2, R16.2
unnamed: IC2.10 (OUTB), R17.2, R18.2
unnamed: C15.1, C16.1, C20.1, C23.2, IC2.16 (VDDA), PS1.3 (+VOUT)
unnamed: C21.1, C24.1, C45.1, C52.1, IC2.11 (VDDB), PS3.3 (+VOUT)
unnamed: C15.2, C16.2, C20.2, C23.1, C50.1, IC2.14 (VSSA), J5.1, J5.2, J5.3, J5.4, PS1.4 (-VOUT), Q2.3 (S), Q3.2 (D), R19.2, R22.2
unnamed: C1.1, IC3.6 (DT), R1.2
unnamed: C2.2, IC3.1 (INA), R2.2
unnamed: C3.2, IC3.2 (INB), R3.2
unnamed: IC3.15 (OUTA), R6.2, R7.2
unnamed: IC3.10 (OUTB), R9.2, R10.2
unnamed: C5.1, C7.1, C12.2, C19.1, IC3.16 (VDDA), PS2.3 (+VOUT)
unnamed: C47.1, C48.1, C55.1, C56.1, IC3.11 (VDDB), PS4.3 (+VOUT)
unnamed: C5.2, C7.2, C12.1, C14.1, C19.2, IC3.14 (VSSA), PS2.4 (-VOUT), Q1.2 (D), Q5.3 (S), R8.2, R21.2, U5.2 (IN_1), U5.3 (IN_2), U5.4 (IN_3), U5.5 (IN_4)
unnamed: D6.2, Q1.1 (G), R10.1, R11.1
unnamed: D2.2, Q2.1 (G), R16.1, R19.1
unnamed: D3.2, Q3.1 (G), R18.1, R20.1
unnamed: D1.2, Q5.1 (G), R6.1, R8.1
unnamed: J1.1, J1.2, J1.3, J1.4, U5.6 (OUT_1), U5.7 (OUT_2), U5.8 (OUT_3), U5.9 (OUT_4)
unnamed: R25.1, U5.12 (VOUT)
PWM_AH: R2.1; also elsewhere on the board
PWM_AL: R3.1; also elsewhere on the board
PWM_BH: R4.1; also elsewhere on the board
PWM_BL: R5.1; also elsewhere on the board

Notes on the sheet:
RGATE
RGATE
COIL TERMINALS
SNUBBER FOOTPRINT
HIGH CURRENT PRINTED CIRCUIT BOARD POWER TAP
Con un enable me vale?
FUSE?
Bleeder Resistor tau= 10mF*3.3kOhm = 33s
He de separar ground analogico de digital?
Esto se calienta mucho. Hablar con miguel sobre disipación térmica.
D1,D2,D3,D4 No tienen courtyard
Flyback Diodes
Con una sensibilidad de 104.2 mV/A, usar una referencia de 2.5 V limita el rango positivo a: Imax =(3.3−2.5)/0.1042 = 7.7 𝐴 mientras que con una referencia de 1.65 V se obtiene: Imax = (3.3 − 1.65)/0.1042 = 15.8 Por tanto, 1.65 V permite un rango prácticamente simétrico y maximiza el uso del ADC, a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
Concretar con miguel si Clamp o divisor resistivo.BAT54C?

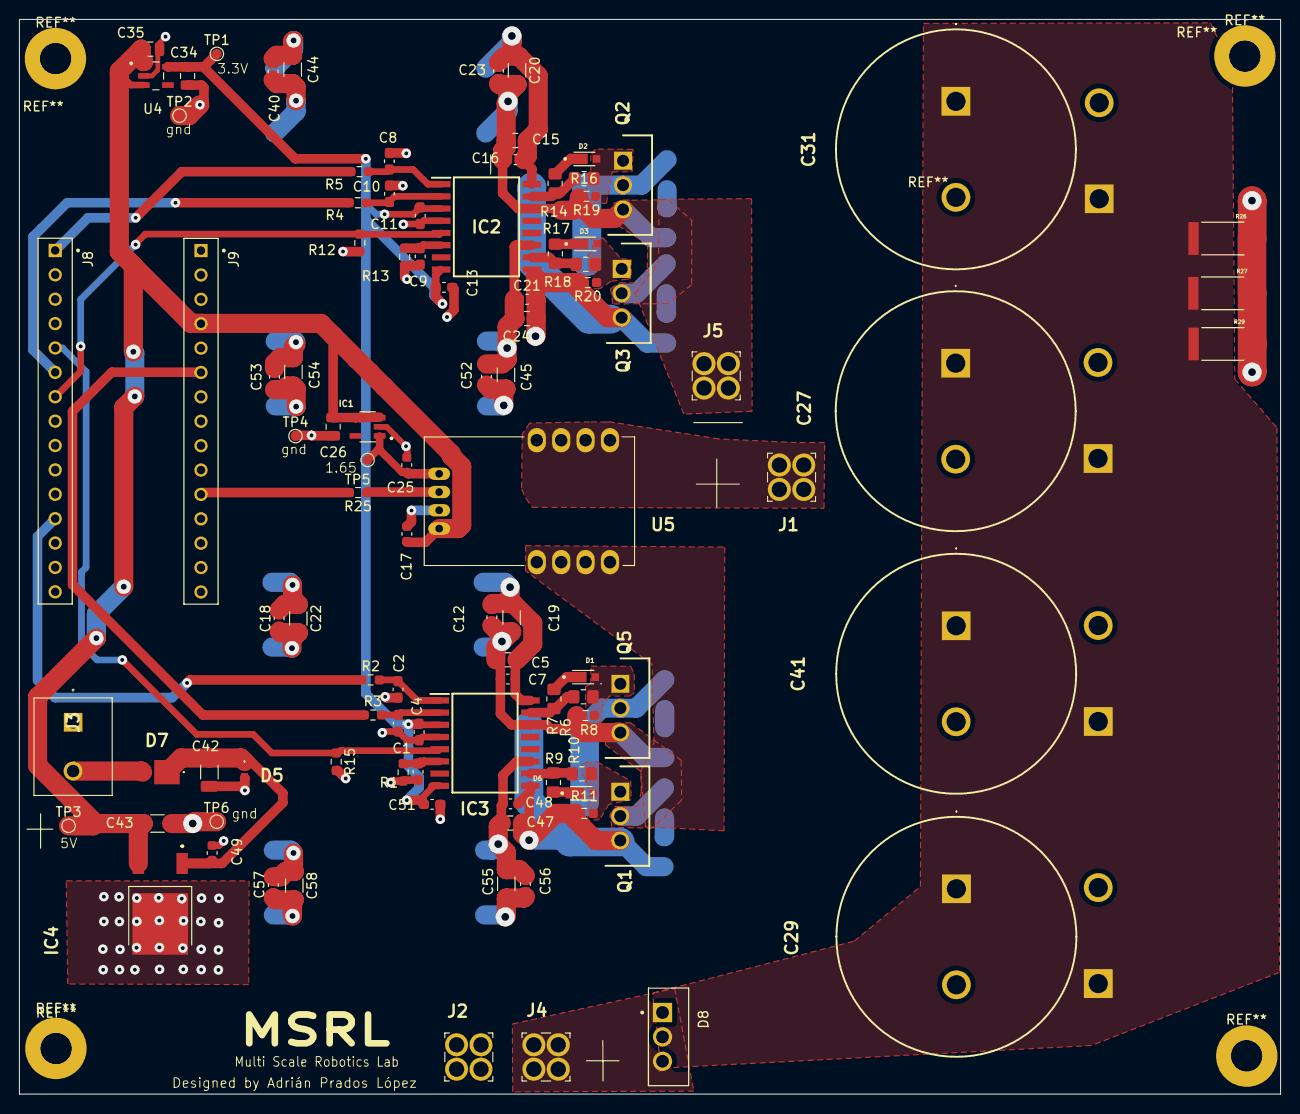
[picture p26: board Adrion_1.kicad_pcb from above]

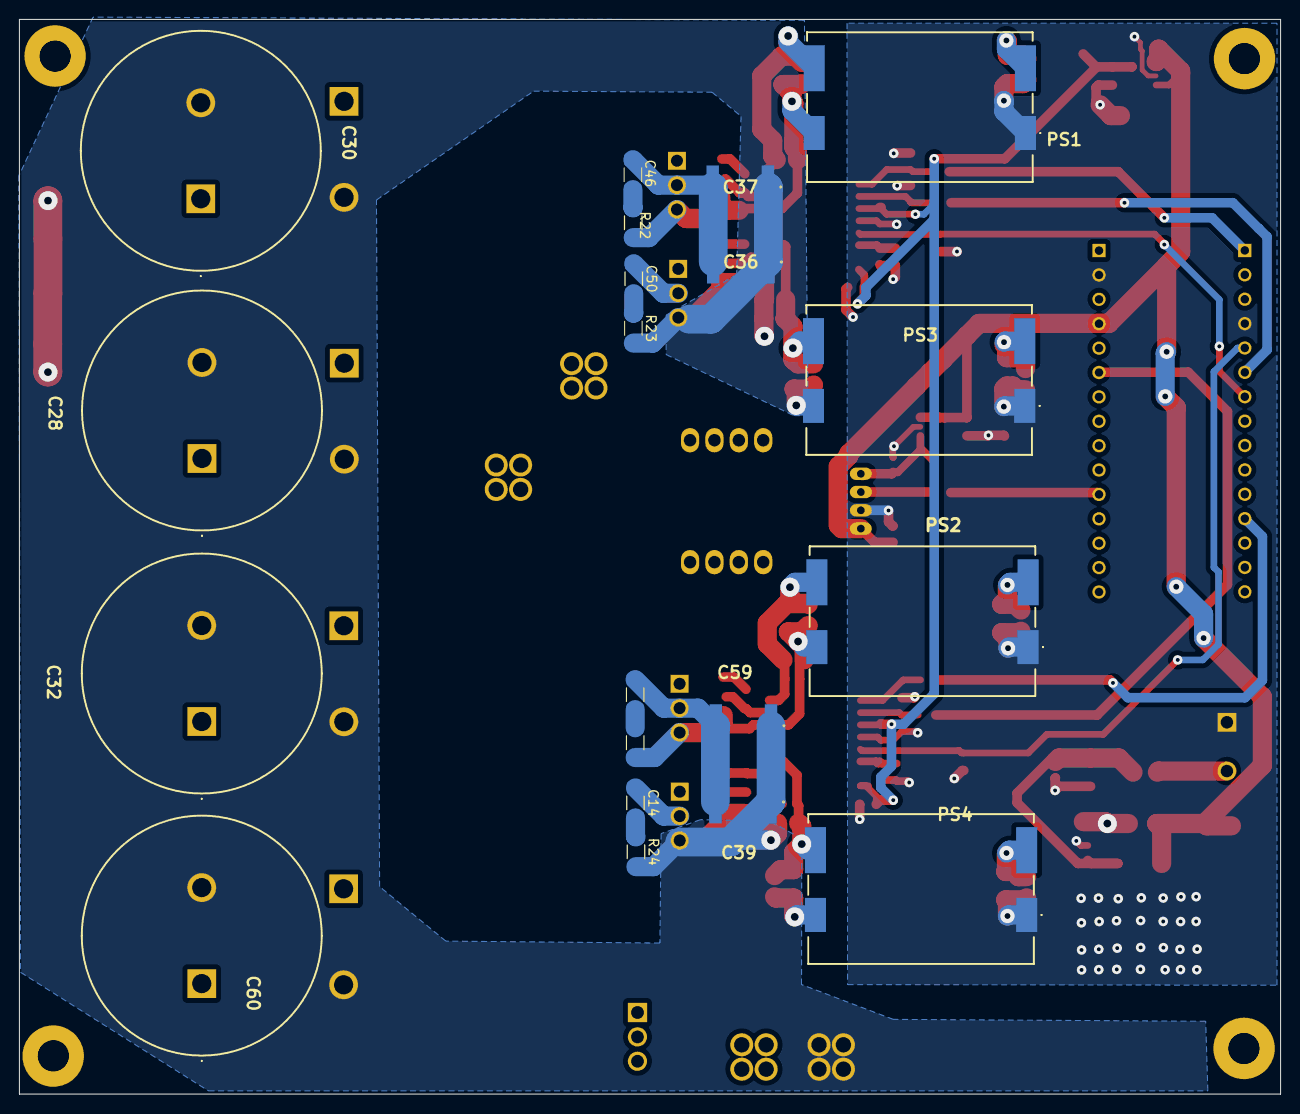
[picture p27: board Adrion_1.kicad_pcb from below]

Board: 4 copper layers, 131.4 x 111.9 mm, 120 parts (20 on the bottom side), 46 nets.
