Adrisbd11/Custom-Nanorobot-Control-Inverter/(commit log)

2026-03-27 Add Adrion_1 KiCad project and backups
    Add new KiCad project "Adrion_1": initial PCB file (Adrion_1.kicad_pcb), project settings (.kicad_prl, .kicad_pro) and schematics (Adrion_1.kicad_sch, Adrion_1.kicad_sch-bak, Power_Stage.kicad_sch, supply.kicad_sch, untitled.kicad_sch). Also add ten backup archives under Adrion_1/Adrion_1-backups (multiple 2026-03-23 to 2026-03-27 ZIPs). Power_Stage.kicad_sch is a large schematic with many symbol definitions and components.
    [Adrion_1.kicad_pcb, Adrion_1.kicad_sch, Power_Stage.kicad_sch, supply.kicad_sch, untitled.kicad_sch]
2026-04-15 Correcion railes de tension papa
    [Adrion_1.kicad_sch, supply.kicad_sch, untitled.kicad_sch]
2026-04-28 Mamita he empezado el layout. Vaya show
    [Adrion_1.kicad_pcb, supply.kicad_sch, untitled.kicad_sch]
2026-04-30 Routing, Placement, Datasheets actualizado
    [1705469.PcbLib, 1705469.SchLib, 1705469.psm, 1705469.stp, 1729128.psm, 1729128.stp, 6130XX11821_61301811821.step, Adrion_1.kicad_pcb]
2026-04-30 arrreglos, venitilador y disipadores primera version
    [Adrion_1.kicad_pcb, Power_Stage.kicad_sch]
2026-05-08 FirstPrototype
    First Prototype sent
    [Adrion_1-B_Cu.gbr, Adrion_1-B_Mask.gbr, Adrion_1-B_Paste.gbr, Adrion_1-B_Silkscreen.gbr, Adrion_1-CuBottom.gbr, Adrion_1-CuIn1.gbr, Adrion_1-CuIn2.gbr, Adrion_1-CuTop.gbr]
